K3ndev/BinaryClock/BOM.csv

Reference | Qty | Value | Footprint | LCSC Part | price(usd) | price(huf) | total(usd) | total(huf)
C1,C4,C5,C6,C7,C8,C9,C10,C11,C12,C13,C14,C15,C16,C17,C19 | 16 | 100nF | Resistor_SMD:R_0603_1608Metric | C1591 | 0.0075 | 2.46 | 0.12 | 39.35
C2,C3 | 2 | 22 pF | Resistor_SMD:R_0603_1608Metric | C326840 | 0.0149 | 4.89 | 0.0298 | 9.77
C18 | 1 | 100uF 35V | Capacitor_SMD:CP_Elec_6.3x7.7 | C72478 | 0.0338 | 11.08 | 0.0338 | 11.08
D1,D2,D3,D4,D5,D6,D7,D8,D9,D10,D11,D12,D13,D14,D15,D16,D17,D18,D19,D20,D21,D22,D23,D24 | 24 | Green LED | LED_SMD:LED_1206_3216Metric | C375482 | 0.0261 | 8.56 | 0.6264 | 205.40
J1 | 1 | USB_C_Receptacle_PowerOnly_6P | Connector_USB:USB_C_Receptacle_GCT_USB4125-xx-x-0190_6P_TopMnt_Horizontal | C18357552 | 0.0467 | 15.31 | 0.0467 | 15.31
R1 | 1 | 330k | Resistor_SMD:R_0603_1608Metric | C2907027 | 0.002 | 0.66 | 0.002 | 0.66
R2 | 1 | 10M | Resistor_SMD:R_0603_1608Metric | C2930145 | 0.0024 | 0.79 | 0.0024 | 0.79
R3,R5,R7,R9 | 4 | 100k | Resistor_SMD:R_0603_1608Metric | C14675 | 0.0022 | 0.72 | 0.0088 | 2.89
R4,R6,R8,R10 | 4 | 10k | Resistor_SMD:R_0603_1608Metric | C98220 | 0.0027 | 0.89 | 0.0108 | 3.54
R11,R12 | 2 | 5.1k | Resistor_SMD:R_0603_1608Metric | C2907044 | 0.0018 | 0.59 | 0.0036 | 1.18
RN1,RN2,RN3,RN4,RN5,RN6 | 6 | 330Ω | Resistor_SMD:R_Array_Convex_4x1206 | C12018 | 0.0214 | 7.02 | 0.1284 | 42.10
SW1,SW2,SW3,SW4 | 4 | SW_Push 6x6x5.5mm | Button_Switch_THT:SW_PUSH_6mm_H5mm | C42416244 | 0.0203 | 6.66 | 0.0812 | 26.63
U1 | 1 | 4013 | Package_SO:SOIC-14_3.9x8.7mm_P1.27mm | C13527 | 0.2526 | 82.83 | 0.2526 | 82.83
U2 | 1 | 4060 | Package_SO:SOIC-16_3.9x9.9mm_P1.27mm | C134017 | 0.4094 | 134.24 | 0.4094 | 134.24
U3,U10 | 2 | 4081 | Package_SO:SOIC-14_3.9x8.7mm_P1.27mm | C40551 | 0.3278 | 107.49 | 0.6556 | 214.97
U4,U5,U6,U8,U9,U11 | 6 | 4510 | Package_SO:TSSOP-16_4.4x5mm_P0.65mm | C2862976 | 0.8473 | 277.83 | 5.0838 | 1666.98
U7 | 1 | 4071 | Package_SO:SOIC-14_3.9x8.7mm_P1.27mm | C97039 | 0.4982 | 163.36 | 0.4982 | 163.36
Y1 | 1 | 32.768 kHz | Crystal:Crystal_C38-LF_D3.0mm_L8.0mm_Horizontal | C3034396 | 0.0972 | 31.87 | 0.0972 | 31.87
pcb | 1 | "2 layer" | - | - | 11.22 | 3679 | 11.22 | 3679
3D Printing | 1 | 35g | - | - | 1 | 330 | 1 | 330
shipping |  |  |  | - | 10 | 3000 | 10 | 3000
Total (BOM qty) |  |  |  |  |  |  | 30.3107 | 9661.95
Total (LCSC min. order) |  |  |  |  |  |  | 37.2163 | 11926.29
