K3ndev/BinaryClock/3d modells/project files/assembly.FCStd

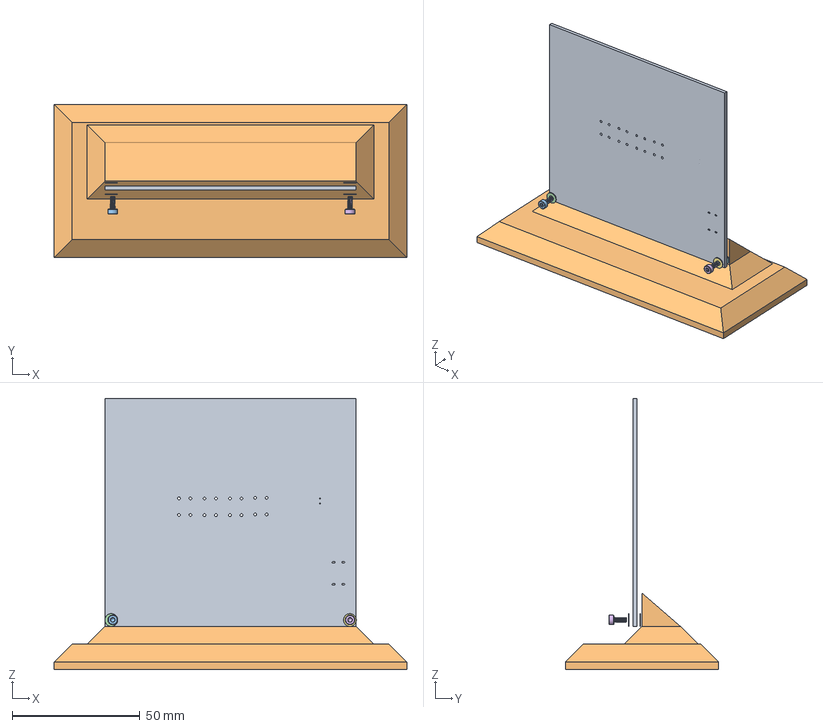
[picture p4: CAD file, 2026-11-01]
3d modells/project files/assembly.FCStd
138.3 x 60.0 x 106.3 mm
BinaryClock-unsaved-export-BoGoj2_PCB
holder
M2x5-Screw
M2-Washer
M2-Washer002
M2x5-Screw002
M2-Washer009
M2-Washer010
