K3ndev/BinaryClock/3d modells/step files/assembly.3mf.step

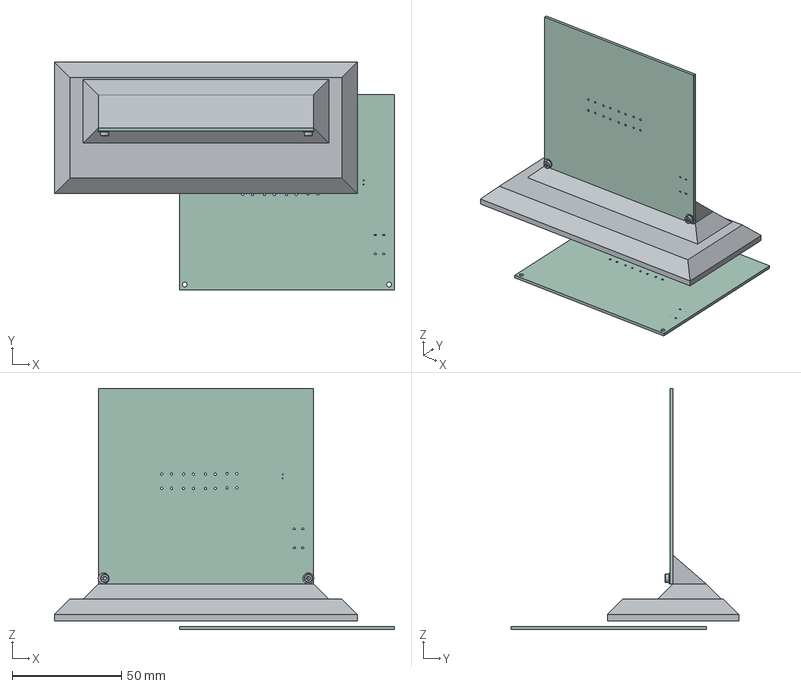
[picture p5: CAD file, 2026-11-01]
3d modells/step files/assembly.3mf.step
155.3 x 104.0 x 110.3 mm
X-axis x 6
XY-plane x 6
BinaryClock-unsaved-export-BoGoj2_PCB x 2
holder
M2x5-Screw x 2
M2-Washer x 2
