K3ndev/BinaryClock/3d modells/step files/BinaryClock.step

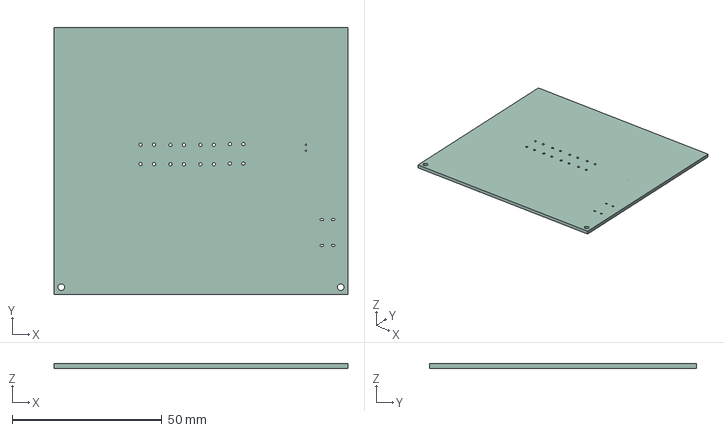
[picture p6: CAD file, 2026-11-01]
3d modells/step files/BinaryClock.step
98.3 x 89.3 x 1.51 mm
