K3ndev/BinaryClock/BinaryClock.kicad_pcb

## KiCad design BinaryClock.kicad_pcb (2026-10-16)

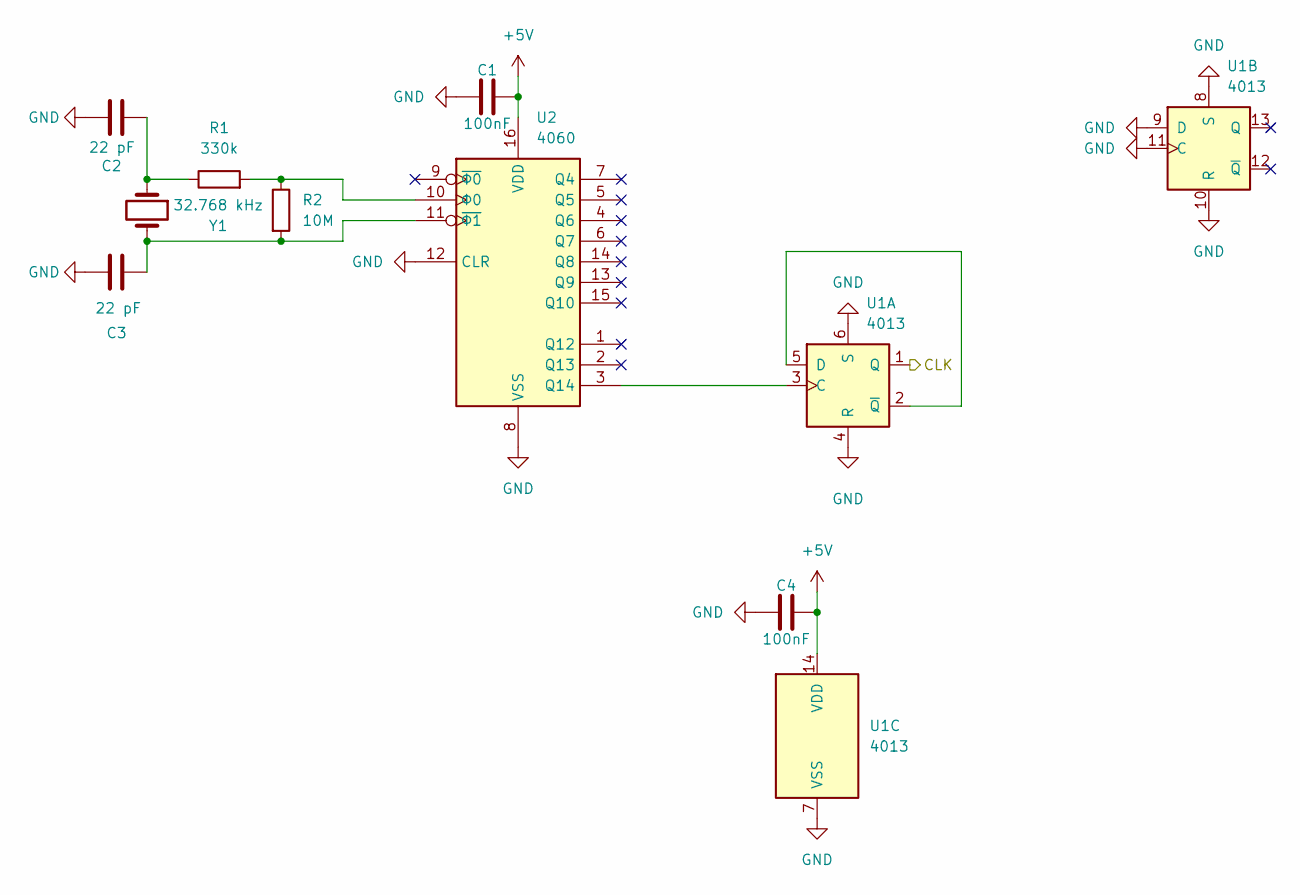
[picture p7: schematic clk.kicad_sch]

Parts:
C1, C4: 100nF; R_0603_1608Metric; LCSC Part C1591
C2, C3: 22 pF; R_0603_1608Metric; LCSC Part C326840
R1: 330k; R_0603_1608Metric; LCSC Part C2907027
R2: 10M; R_0603_1608Metric; LCSC Part C2930145
U1: 4013; SOIC-14_3.9x8.7mm_P1.27mm; LCSC Part C13527
U2: 4060; SOIC-16_3.9x9.9mm_P1.27mm; LCSC Part C134017
Y1: 32.768 kHz; Crystal_C38-LF_D3.0mm_L8.0mm_Horizontal; LCSC Part C3034396

Connections:
+5V: C1.2, C4.2, U1.14 (VDD), U2.16 (VDD); also elsewhere on the board
/Clk/CLK: U1.1 (Q); also elsewhere on the board
GND: C1.1, C2.2, C3.2, C4.1, U1.4 (R), U1.6 (S), U1.7 (VSS), U1.8 (S), U1.9 (D), U1.10 (R), U1.11 (C), U2.8 (VSS), U2.12 (CLR); also elsewhere on the board
unnamed: C2.1, R1.1, Y1.1
unnamed: U1.3 (C), U2.3 (Q14)
unnamed: U1.2 (~Q), U1.5 (D)
unnamed: C3.1, R2.2, U2.11 (~Φ1), Y1.2
unnamed: R1.2, R2.1, U2.10 (Φ0)

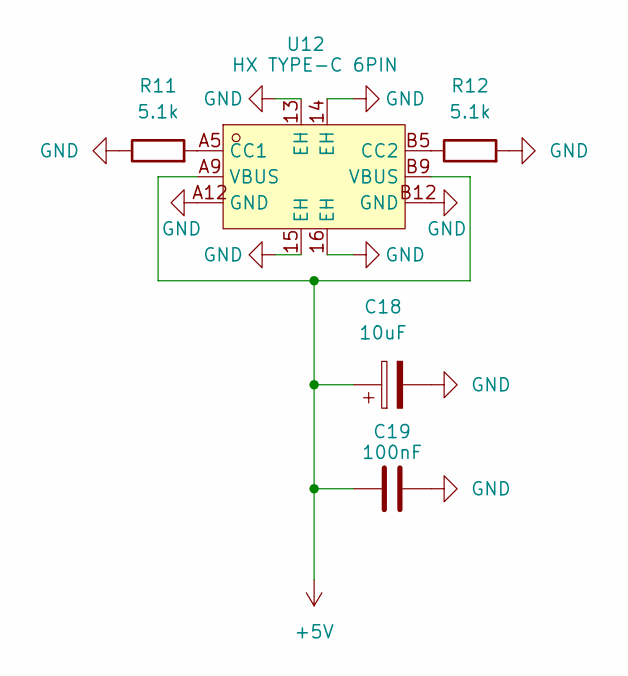
[picture p8: schematic power.kicad_sch]

Parts:
C18: 10uF; CP_Elec_6.3x7.7; LCSC Part C72478
C19: 100nF; R_0603_1608Metric; LCSC Part C1591
R11, R12: 5.1k; R_0603_1608Metric; LCSC Part C2907044
U12: HX TYPE-C 6PIN; USB-C-SMD_HX-TYPE-C-6PIN; MPN HX TYPE-C 6PIN; LCSC Part C18357552

Connections:
+5V: C18.1, C19.1, U12.A9 (VBUS), U12.B9 (VBUS); also elsewhere on the board
GND: C18.2, C19.2, R11.1, R12.2, U12.13 (EH), U12.14 (EH), U12.15 (EH), U12.16 (EH), U12.A12 (GND), U12.B12 (GND); also elsewhere on the board
unnamed 55: R11.2, U12.A5 (CC1); also elsewhere on the board
unnamed 56: R12.1, U12.B5 (CC2); also elsewhere on the board

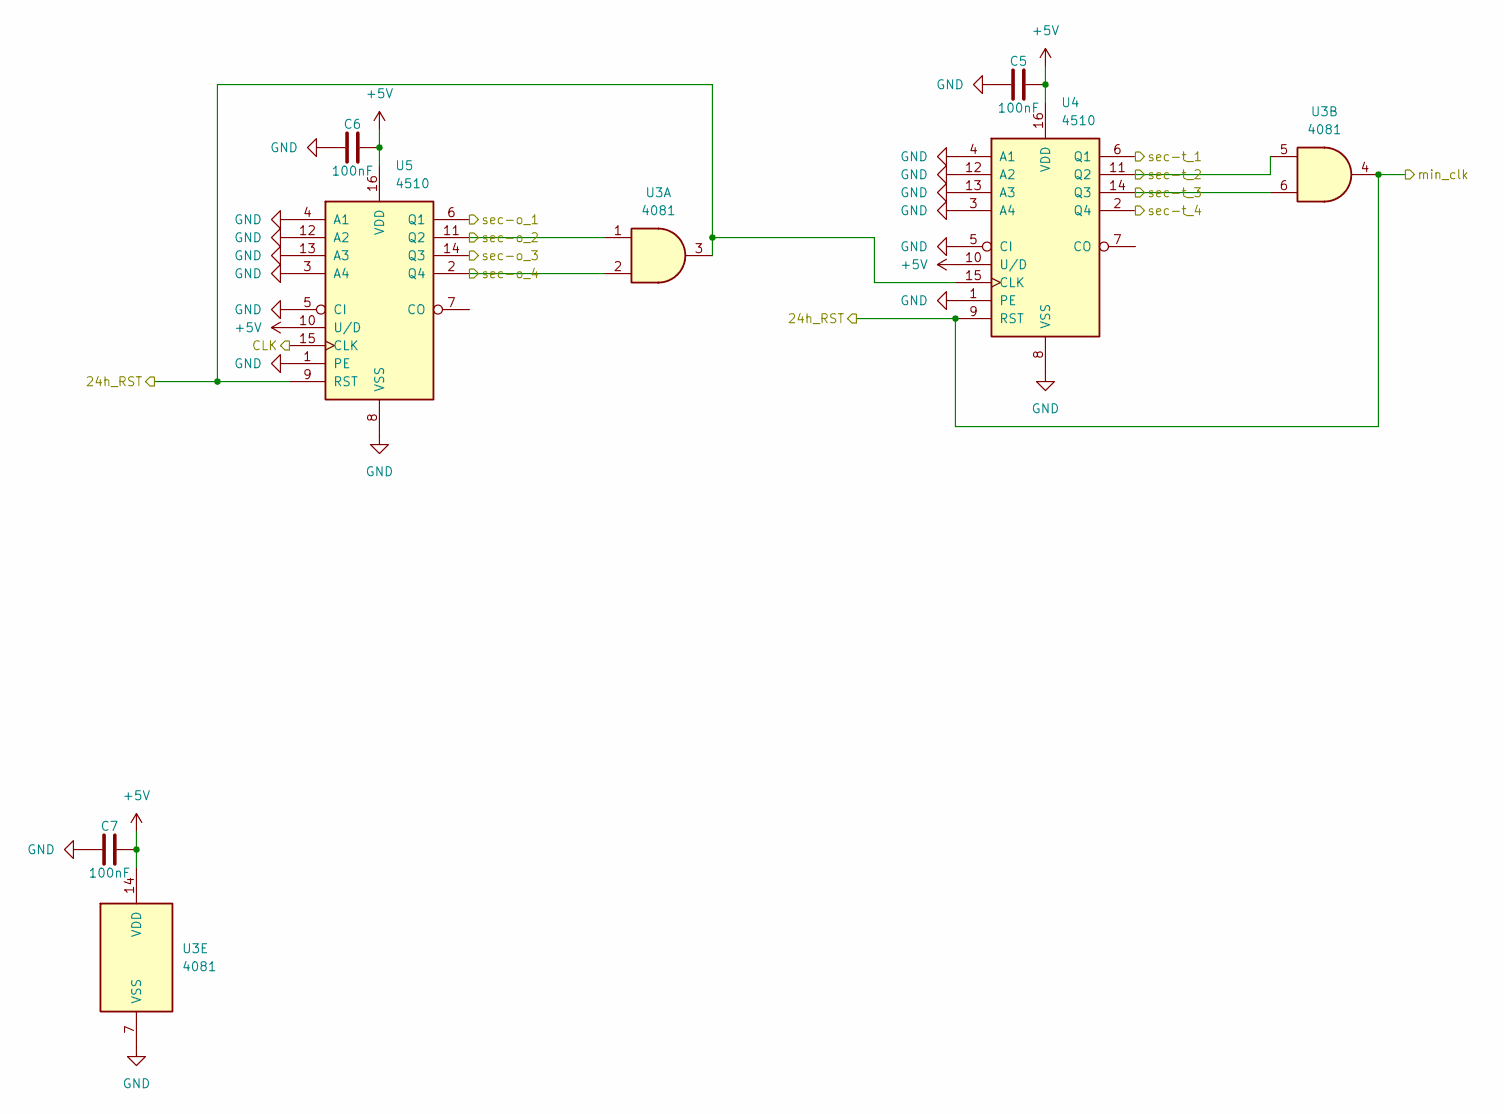
[picture p9: schematic sec.kicad_sch]

Parts:
C5, C6, C7: 100nF; R_0603_1608Metric; LCSC Part C1591
U3: 4081; SOIC-14_3.9x8.7mm_P1.27mm; LCSC Part C40551
U4, U5: 4510; TSSOP-16_4.4x5mm_P0.65mm; LCSC Part C2862976

Connections:
+5V: C5.2, C6.2, C7.2, U3.14 (VDD), U4.10 (U/D), U4.16 (VDD), U5.10 (U/D), U5.16 (VDD); also elsewhere on the board
/Clk/CLK: U5.15 (CLK); also elsewhere on the board
/Counters/hour/24h_RST: U3.3, U3.4, U4.9 (RST), U4.15 (CLK), U5.9 (RST); also elsewhere on the board
/Counters/sec/sec-o_1: U5.6 (Q1); also elsewhere on the board
/Counters/sec/sec-o_2: U3.1, U5.11 (Q2); also elsewhere on the board
/Counters/sec/sec-o_3: U5.14 (Q3); also elsewhere on the board
/Counters/sec/sec-o_4: U3.2, U5.2 (Q4); also elsewhere on the board
/Counters/sec/sec-t_1: U4.6 (Q1); also elsewhere on the board
/Counters/sec/sec-t_2: U3.5, U4.11 (Q2); also elsewhere on the board
/Counters/sec/sec-t_3: U3.6, U4.14 (Q3); also elsewhere on the board
/Counters/sec/sec-t_4: U4.2 (Q4); also elsewhere on the board
GND: C5.1, C6.1, C7.1, U3.7 (VSS), U4.1 (PE), U4.3 (A4), U4.4 (A1), U4.5 (CI), U4.8 (VSS), U4.12 (A2), U4.13 (A3), U5.1 (PE), U5.3 (A4), U5.4 (A1), U5.5 (CI), U5.8 (VSS), U5.12 (A2), U5.13 (A3); also elsewhere on the board

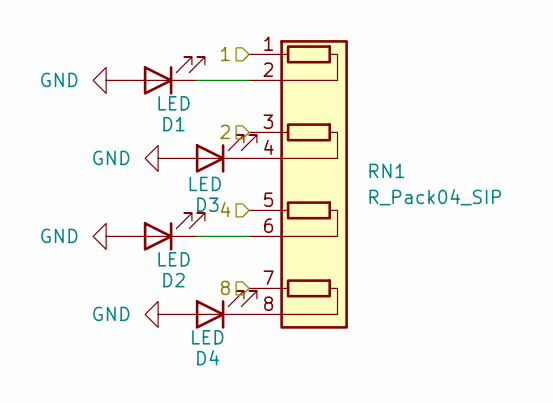
[picture p10: schematic sec_display.kicad_sch]

Parts:
D1, D2, D3, D4: LED; LED_1206_3216Metric; LCSC Part C375482
RN1: R_Pack04_SIP; R_Array_SIP8; LCSC Part C12018

Connections:
/Counters/sec/sec-o_1: RN1.1 (R1.1); also elsewhere on the board
/Counters/sec/sec-o_2: RN1.3 (R2.1); also elsewhere on the board
/Counters/sec/sec-o_3: RN1.5 (R3.1); also elsewhere on the board
/Counters/sec/sec-o_4: RN1.7 (R4.1); also elsewhere on the board
GND: D1.2 (A), D2.2 (A), D3.2 (A), D4.2 (A); also elsewhere on the board
unnamed: D1.1 (K), RN1.2 (R1.2)
unnamed: D4.1 (K), RN1.8 (R4.2)

Parts of its further copies:
D5, D6, D7, D8, D9, D10, D11, D12, D13, D14, D15, D16, D17, D18, D19, D20, D21, D22, D23, D24: LED; LED_1206_3216Metric; LCSC Part C375482
RN2, RN3, RN4, RN5, RN6: R_Pack04_SIP; R_Array_SIP8; LCSC Part C12018

Connections of its further copies:
/Counters/hour/hour-o_1: RN4.1 (R1.1); also elsewhere on the board
/Counters/hour/hour-o_2: RN4.3 (R2.1); also elsewhere on the board
/Counters/hour/hour-o_3: RN4.5 (R3.1); also elsewhere on the board
/Counters/hour/hour-o_4: RN4.7 (R4.1); also elsewhere on the board
/Counters/hour/hour-t_1: RN6.1 (R1.1); also elsewhere on the board
/Counters/hour/hour-t_2: RN6.3 (R2.1); also elsewhere on the board
/Counters/hour/hour-t_3: RN6.5 (R3.1); also elsewhere on the board
/Counters/hour/hour-t_4: RN6.7 (R4.1); also elsewhere on the board
/Counters/min/min-o_1: RN3.1 (R1.1); also elsewhere on the board
/Counters/min/min-o_2: RN3.3 (R2.1); also elsewhere on the board
/Counters/min/min-o_3: RN3.5 (R3.1); also elsewhere on the board
/Counters/min/min-o_4: RN3.7 (R4.1); also elsewhere on the board
/Counters/min/min-t_1: RN5.1 (R1.1); also elsewhere on the board
/Counters/min/min-t_2: RN5.3 (R2.1); also elsewhere on the board
/Counters/min/min-t_3: RN5.5 (R3.1); also elsewhere on the board
/Counters/min/min-t_4: RN5.7 (R4.1); also elsewhere on the board
/Counters/sec/sec-t_1: RN2.1 (R1.1); also elsewhere on the board
/Counters/sec/sec-t_2: RN2.3 (R2.1); also elsewhere on the board
/Counters/sec/sec-t_3: RN2.5 (R3.1); also elsewhere on the board
/Counters/sec/sec-t_4: RN2.7 (R4.1); also elsewhere on the board
GND: D5.2 (A), D6.2 (A), D7.2 (A), D8.2 (A), D9.2 (A), D10.2 (A), D11.2 (A), D12.2 (A), D13.2 (A), D14.2 (A), D15.2 (A), D16.2 (A), D17.2 (A), D18.2 (A), D19.2 (A), D20.2 (A), D21.2 (A), D22.2 (A), D23.2 (A), D24.2 (A); also elsewhere on the board
unnamed: D5.1 (K), RN2.2 (R1.2)
unnamed: D6.1 (K), RN2.4 (R2.2)
unnamed: D7.1 (K), RN2.6 (R3.2)
unnamed: D8.1 (K), RN2.8 (R4.2)
unnamed: D9.1 (K), RN3.2 (R1.2)
unnamed: D10.1 (K), RN3.4 (R2.2)
unnamed: D11.1 (K), RN3.6 (R3.2)
unnamed: D12.1 (K), RN3.8 (R4.2)
unnamed: D13.1 (K), RN4.2 (R1.2)
unnamed: D14.1 (K), RN4.4 (R2.2)
unnamed: D15.1 (K), RN4.6 (R3.2)
unnamed: D16.1 (K), RN4.8 (R4.2)
unnamed: D17.1 (K), RN5.2 (R1.2)
unnamed: D18.1 (K), RN5.4 (R2.2)
unnamed: D19.1 (K), RN5.6 (R3.2)
unnamed: D20.1 (K), RN5.8 (R4.2)
unnamed: D21.1 (K), RN6.2 (R1.2)
unnamed: D22.1 (K), RN6.4 (R2.2)
unnamed: D23.1 (K), RN6.6 (R3.2)
unnamed: D24.1 (K), RN6.8 (R4.2)

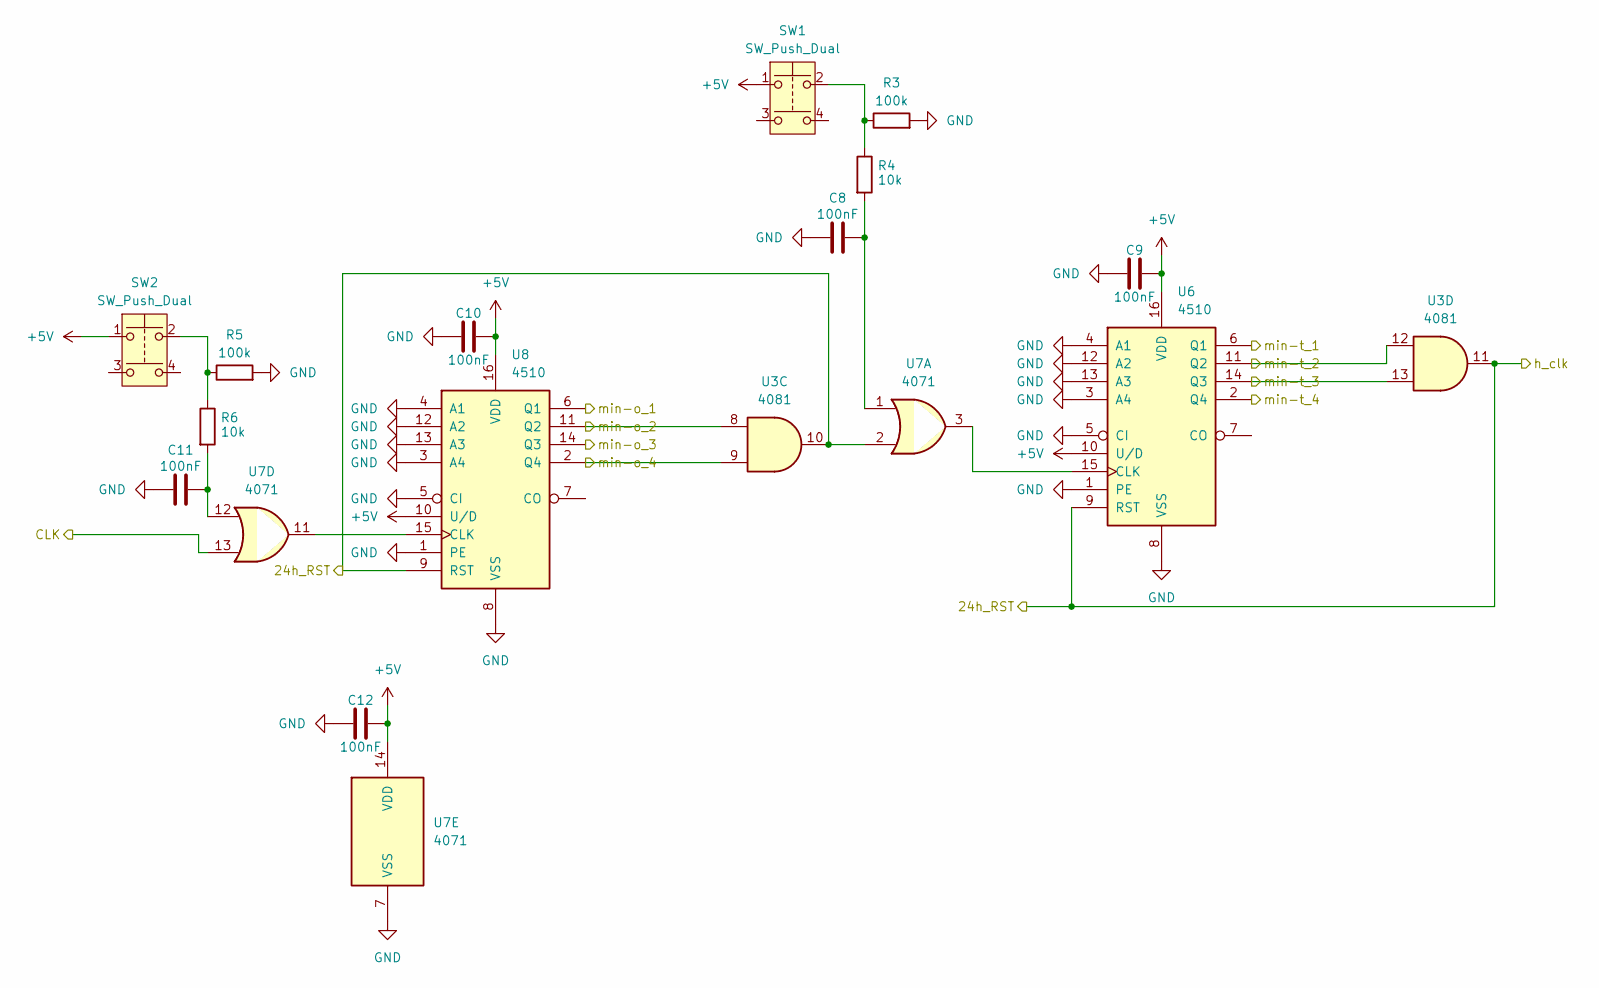
[picture p11: schematic min.kicad_sch]

Parts:
C8, C9, C10, C11, C12: 100nF; R_0603_1608Metric; LCSC Part C1591
R3, R5: 100k; R_0603_1608Metric; LCSC Part C14675
R4, R6: 10k; R_0603_1608Metric; LCSC Part C98220
SW1, SW2: SW_Push_Dual; SW_PUSH_6mm_H5mm; LCSC Part C42416244
U3: 4081; SOIC-14_3.9x8.7mm_P1.27mm; LCSC Part C40551
U6, U8: 4510; TSSOP-16_4.4x5mm_P0.65mm; LCSC Part C2862976
U7: 4071; SOIC-14_3.9x8.7mm_P1.27mm; LCSC Part C97039

Connections:
+5V: C9.2, C10.2, C12.2, SW1.1, SW2.1, U6.10 (U/D), U6.16 (VDD), U7.14 (VDD), U8.10 (U/D), U8.16 (VDD); also elsewhere on the board
/Counters/hour/24h_RST: U3.10, U3.11, U6.9 (RST), U7.2, U7.13, U8.9 (RST); also elsewhere on the board
/Counters/min/min-o_1: U8.6 (Q1); also elsewhere on the board
/Counters/min/min-o_2: U3.8, U8.11 (Q2); also elsewhere on the board
/Counters/min/min-o_3: U8.14 (Q3); also elsewhere on the board
/Counters/min/min-o_4: U3.9, U8.2 (Q4); also elsewhere on the board
/Counters/min/min-t_1: U6.6 (Q1); also elsewhere on the board
/Counters/min/min-t_2: U3.12, U6.11 (Q2); also elsewhere on the board
/Counters/min/min-t_3: U3.13, U6.14 (Q3); also elsewhere on the board
/Counters/min/min-t_4: U6.2 (Q4); also elsewhere on the board
GND: C8.1, C9.1, C10.1, C11.1, C12.1, R3.2, R5.2, U6.1 (PE), U6.3 (A4), U6.4 (A1), U6.5 (CI), U6.8 (VSS), U6.12 (A2), U6.13 (A3), U7.7 (VSS), U8.1 (PE), U8.3 (A4), U8.4 (A1), U8.5 (CI), U8.8 (VSS), U8.12 (A2), U8.13 (A3); also elsewhere on the board
unnamed: C8.2, R4.2, U7.1
unnamed: C11.2, R6.2, U7.12
unnamed: R3.1, R4.1, SW1.2
unnamed: R5.1, R6.1, SW2.2
unnamed: U6.15 (CLK), U7.3
unnamed: U7.11, U8.15 (CLK)

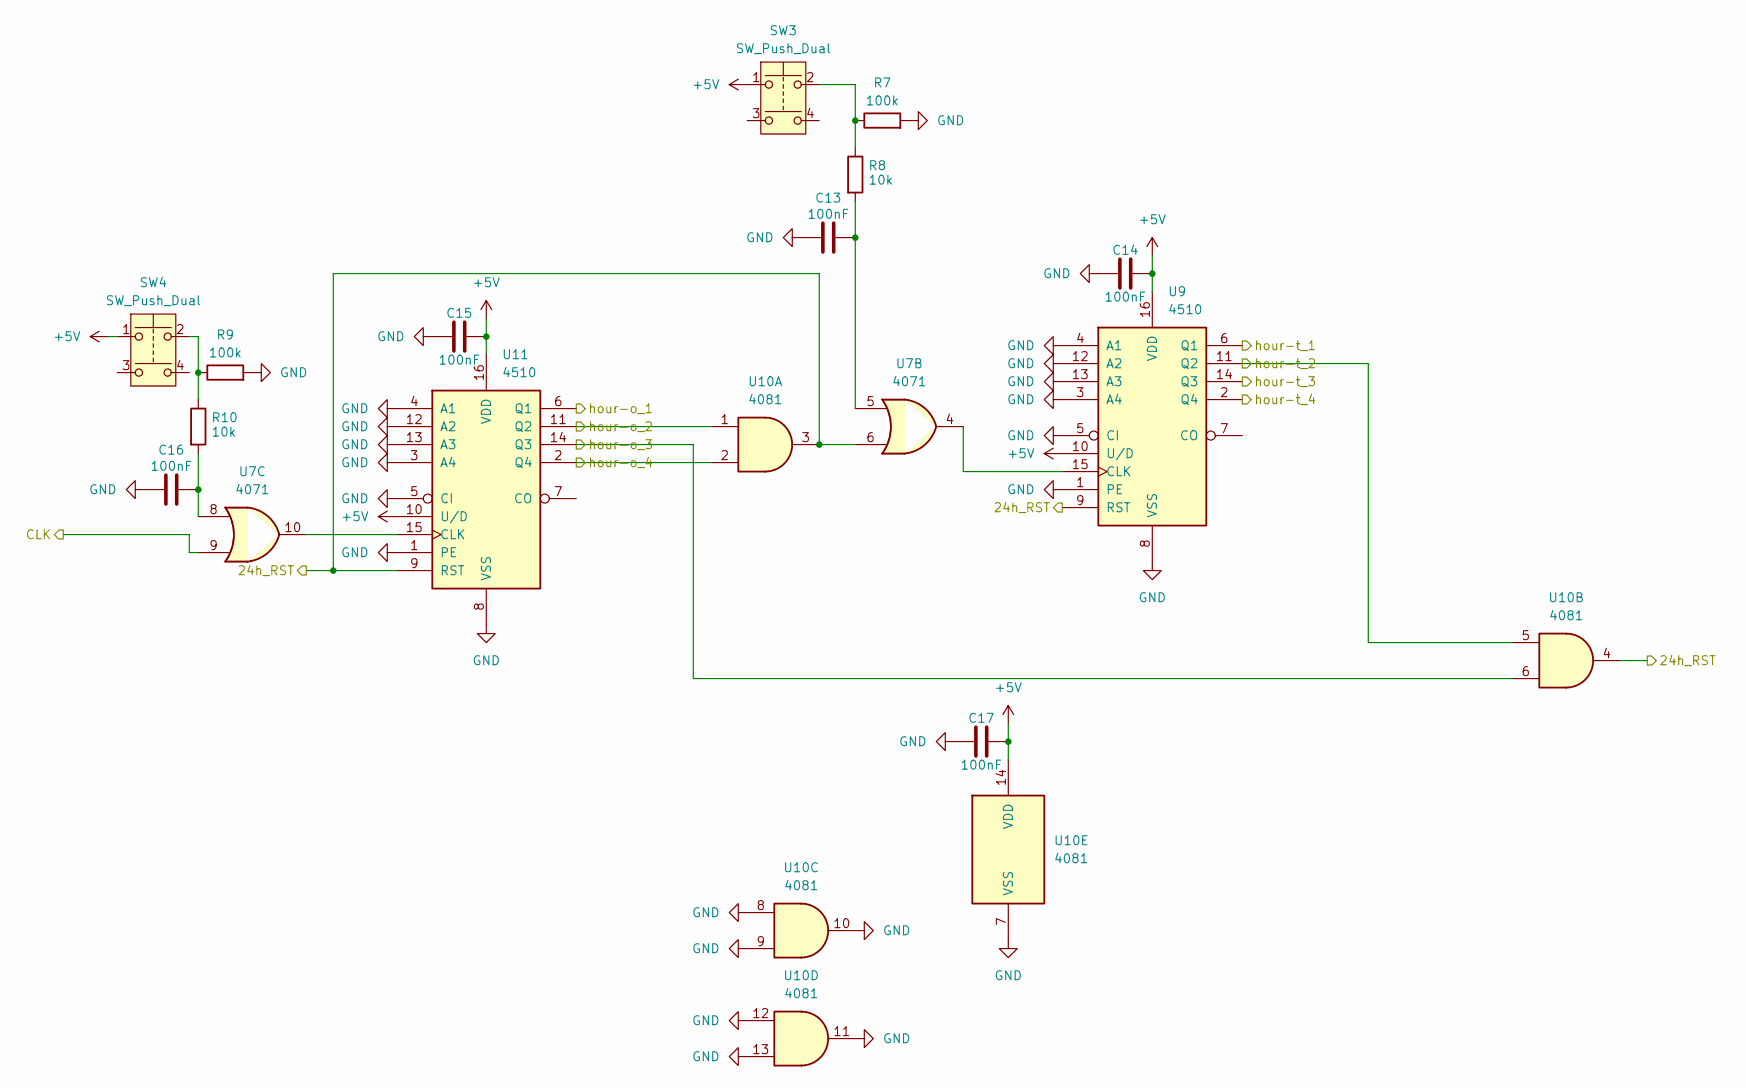
[picture p12: schematic hour.kicad_sch]

Parts:
C13, C14, C15, C16, C17: 100nF; R_0603_1608Metric; LCSC Part C1591
R7, R9: 100k; R_0603_1608Metric; LCSC Part C14675
R8, R10: 10k; R_0603_1608Metric; LCSC Part C98220
SW3, SW4: SW_Push_Dual; SW_PUSH_6mm_H5mm; LCSC Part C42416244
U7: 4071; SOIC-14_3.9x8.7mm_P1.27mm; LCSC Part C97039
U9, U11: 4510; TSSOP-16_4.4x5mm_P0.65mm; LCSC Part C2862976
U10: 4081; SOIC-14_3.9x8.7mm_P1.27mm; LCSC Part C40551

Connections:
+5V: C14.2, C15.2, C17.2, SW3.1, SW4.1, U9.10 (U/D), U9.16 (VDD), U10.14 (VDD), U11.10 (U/D), U11.16 (VDD); also elsewhere on the board
/Counters/hour/24h_RST: U7.6, U7.9, U9.9 (RST), U10.3, U10.4, U11.9 (RST); also elsewhere on the board
/Counters/hour/hour-o_1: U11.6 (Q1); also elsewhere on the board
/Counters/hour/hour-o_2: U10.1, U11.11 (Q2); also elsewhere on the board
/Counters/hour/hour-o_3: U10.6, U11.14 (Q3); also elsewhere on the board
/Counters/hour/hour-o_4: U10.2, U11.2 (Q4); also elsewhere on the board
/Counters/hour/hour-t_1: U9.6 (Q1); also elsewhere on the board
/Counters/hour/hour-t_2: U9.11 (Q2), U10.5; also elsewhere on the board
/Counters/hour/hour-t_3: U9.14 (Q3); also elsewhere on the board
/Counters/hour/hour-t_4: U9.2 (Q4); also elsewhere on the board
GND: C13.1, C14.1, C15.1, C16.1, C17.1, R7.2, R9.2, U9.1 (PE), U9.3 (A4), U9.4 (A1), U9.5 (CI), U9.8 (VSS), U9.12 (A2), U9.13 (A3), U10.7 (VSS), U10.8, U10.9, U10.10, U10.11, U10.12, U10.13, U11.1 (PE), U11.3 (A4), U11.4 (A1), U11.5 (CI), U11.8 (VSS), U11.12 (A2), U11.13 (A3); also elsewhere on the board
unnamed: C13.2, R8.2, U7.5
unnamed: C16.2, R10.2, U7.8
unnamed: R7.1, R8.1, SW3.2
unnamed: R9.1, R10.1, SW4.2
unnamed: U7.4, U9.15 (CLK)
unnamed: U7.10, U11.15 (CLK)

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
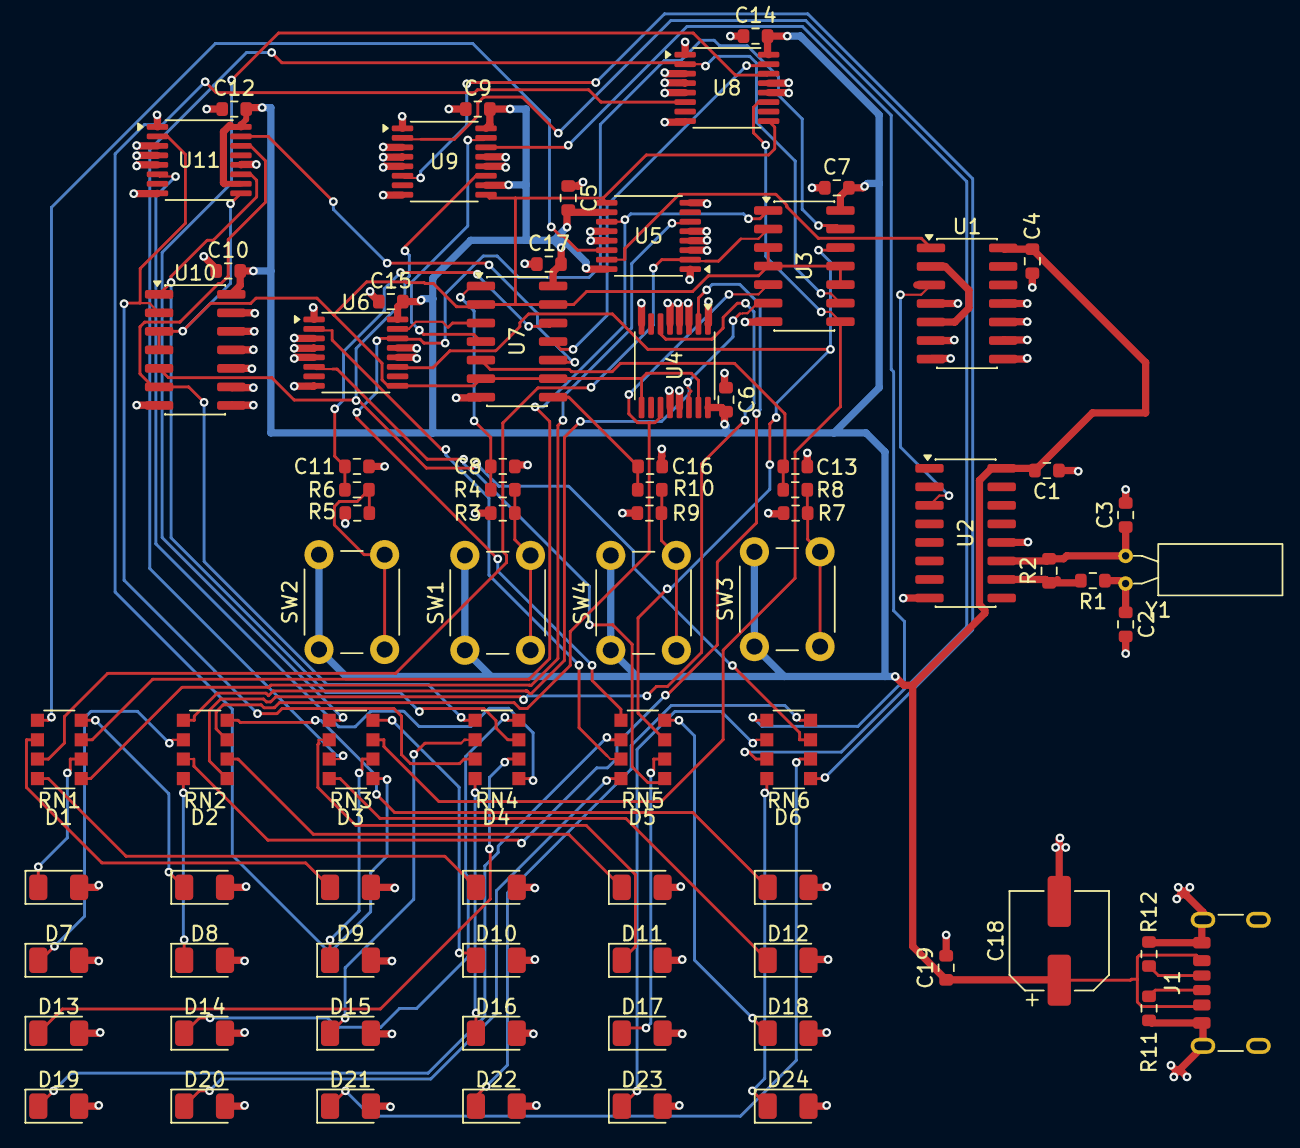
[picture p13: board BinaryClock.kicad_pcb from above]

Board: 2 copper layers, 78 parts (0 on the bottom side), 71 nets.

Other parts of the board:
J1: USB_C_Receptacle_PowerOnly_6P; USB_C_Receptacle_GCT_USB4125-xx-x-0190_6P_TopMnt_Horizontal

Their connections:
+5V: J1.A9 (VBUS), J1.B9 (VBUS); also elsewhere on the board
GND: J1.A12 (GND), J1.B12 (GND), J1.SH (SHIELD); also elsewhere on the board
unnamed 55: J1.A5 (CC1); also elsewhere on the board
unnamed 56: J1.B5 (CC2); also elsewhere on the board
