K3ndev/BinaryClock/JOURNAL.md

---
title: "binaryClock"
author: "kiss-peto.kende"
description: "Its a clock what is displaying the time in binary"
created_at: "2026-09-26"
---

# 2026-10-19: writing the README.md

**Total time spent: 1 hour**

Finally I finished everything.
The README.md is done. And i add an MIT license to the repo. 
It the final devlog before the founding


# 2026-10-19: designing the pcb holder

**Total time spent: 40 min**

what i done:
- taked mesurments from the board
- design the holder in Solidcraft

what is have to done:
- Write the readme.md

# 2026-10-18: Designing the layout pt.4

**Total time spent: 1 hour 48 min**

what i done:
- done the placement
- Rout the power lanes
- Do every other rout with autorouting

what i have to done:
- design the holder for the pcb
- write the readme

# 2026-10-14: Designing the layout pt.3

**Total time spent: 24 mins**

What i done:
- Make the led display matrix
I found a good kicad lib for aligning footprints in a shape


# 2026-10-14: Designing the layout pt.2

**Total time spent: 42 mins**

What i done:
- checked ewery footprint
- designed the power inputs layout
- designed the clock circuit


# 2026-10-14: PCB Layout pt.1

**Total time spent: 21 min**

What i done:
- try to solve a bug about the buttons
turns out a two pin button simbol makes all of a 4 pin buttons pin to one of its own



# 2026-09-28: finding parts and some footprint asigment

**Total time spent: 52 min**

what have i done:
- asign the footprints



what i have to done:
- design the layout 
- design a box for the pcb

# 2026-09-28: designing the shematic pt2

**Total time spent: 2 hour 45min**

what have i done:
- Finished the wireing
- Made the 24hour reset
- fixed some mistakes



what i have to done:
- asign the footprints
- design the layout 
- design a box for the pcb

# 2026-09-28: Designing the shematic pt.1

**Total time spent: 1 hour 40 min.**

what i done:
- Chose the parts for this project
- do some basic wireing


What i have to done:
- finishing the wireing
- adding the 24 hour reset
- asign the footprints
- design the layout
- design a box for the pcb
