K3ndev/BinaryClock/(commit log)

2026-09-01 creating the shematic
    [BinaryClock.kicad_pcb, BinaryClock.kicad_sch]
2026-09-01 making the CLK circuit
    [BinaryClock.kicad_sch, clk.kicad_sch]
2026-09-01 CLK circuit finishing the clk circuit
    [BinaryClock.kicad_sch, clk.kicad_sch]
2026-09-01 adding the file
    [BinaryClock.kicad_sch, sec.kicad_sch, untitled.kicad_sch]
2026-09-01 finishing the sec shematic
    [sec.kicad_sch]
2026-09-01 creating the file
    [min.kicad_sch, sec.kicad_sch, untitled.kicad_sch]
2026-09-02 adding the time seting buttons
    [min.kicad_sch, sec.kicad_sch]
2026-09-02 finishing the min circuit
    [min.kicad_sch, sec.kicad_sch]
2026-09-02 finishing the min circuit nad conect it to its place
    [BinaryClock.kicad_sch, min.kicad_sch, untitled.kicad_sch]
2026-09-02 creating the file and copiing the template
    [hour.kicad_sch, min.kicad_sch, sec.kicad_sch, untitled.kicad_sch]
2026-09-02 Making the circuit for the hour counter
    [clk.kicad_sch, hour.kicad_sch, min.kicad_sch, sec.kicad_sch]
2026-09-02 Making the 24 rst for ewery counter and adding Capacitors
    [clk.kicad_sch, hour.kicad_sch, min.kicad_sch, sec.kicad_sch, untitled.kicad_sch]
2026-09-02 Creating the power sheet
    [BinaryClock.kicad_sch, power.kicad_sch]
2026-09-03 Designing the base circuit of the usb-c
    [BinaryClock.kicad_sch, hour.kicad_sch, power.kicad_sch]
2026-09-03 finished the power input
    [power.kicad_sch]
2026-09-03 Cleaning the shematic
    [clk.kicad_sch, hour.kicad_sch, min.kicad_sch, power.kicad_sch, sec.kicad_sch, sec_display.kicad_sch, untitled.kicad_sch]
2026-09-28 finishing the footprint asigment
    [clk.kicad_sch, hour.kicad_sch, min.kicad_sch, power.kicad_sch, sec.kicad_sch, sec_display.kicad_sch]
2026-09-28 starting the layout
    [BinaryClock.kicad_pcb, clk.kicad_sch, hour.kicad_sch, min.kicad_sch, power.kicad_sch, sec.kicad_sch, sec_display.kicad_sch]
2026-09-29 start to make the clk signal
    [BinaryClock.kicad_pcb, clk.kicad_sch, power.kicad_sch, sec_display.kicad_sch]
2026-10-19 finishing the pcb
2026-10-19 Making a stand for the pcb
2026-10-19 Adding the BOM
2026-11-01 Add PCB entry to BOM.csv
    Added PCB entry to BOM with details.
2026-11-01 Update BOM with prices and add assembled model / README updates
2026-11-01 Update BOM with prices and add assembled model / README updates | part 2
